tibet1987/RC_FanBoat/03_RC_setup/ailerons_as_spolier.jpg

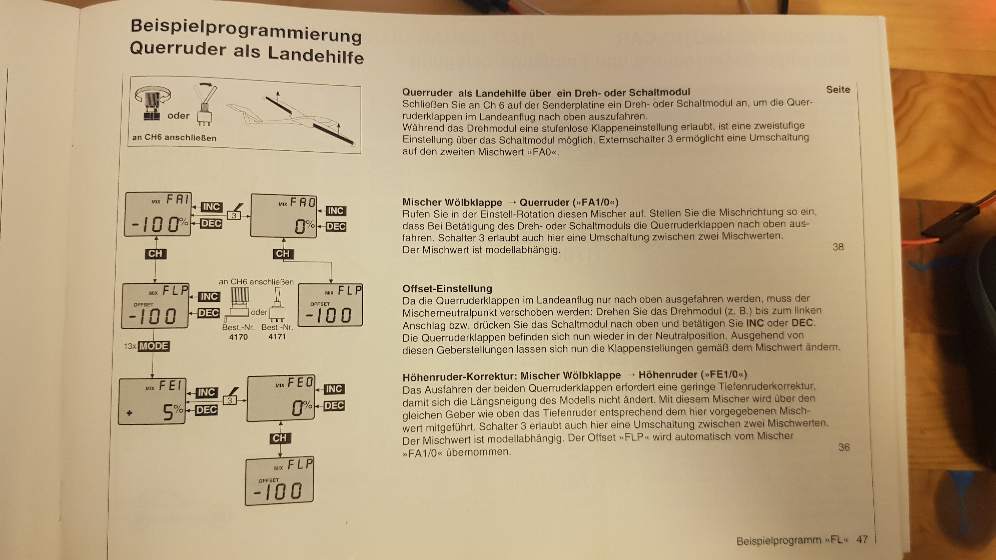
03_RC_setup/ailerons_as_spolier.jpg
