tibet1987/RC_FanBoat/04_Validation/Test_Version3/20210509_220552.jpg

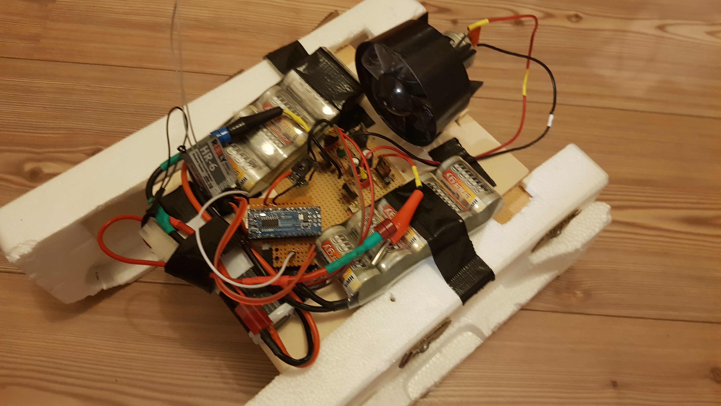
04_Validation/Test_Version3/20210509_220552.jpg
