tibet1987/RC_FanBoat/01_Hardware/Arduino-Nano-pinout.jpg

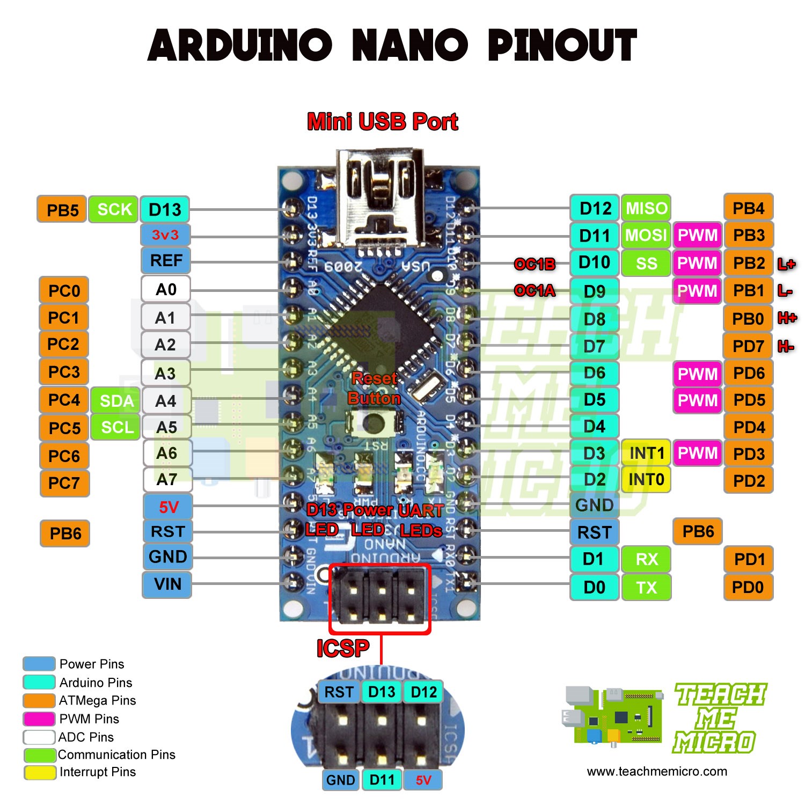
01_Hardware/Arduino-Nano-pinout.jpg
