tibet1987/RC_FanBoat/01_Hardware/Board_Layout.png

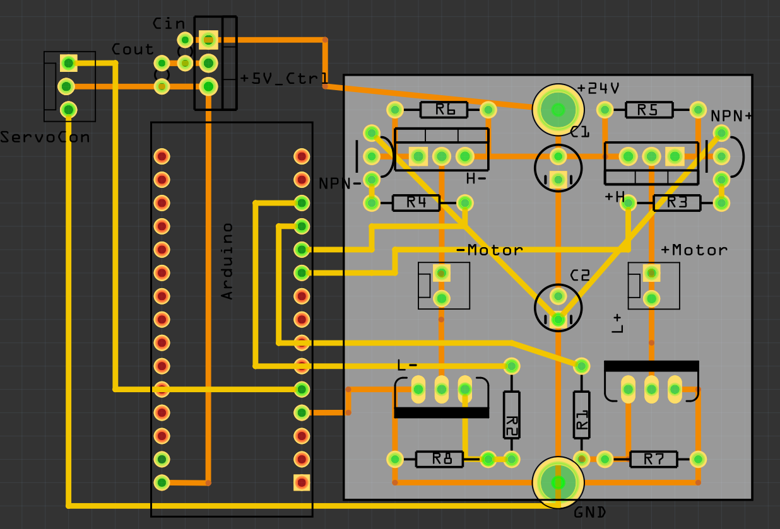
01_Hardware/Board_Layout.png
