tibet1987/RC_FanBoat/01_Hardware/FullBridge_Ports.png

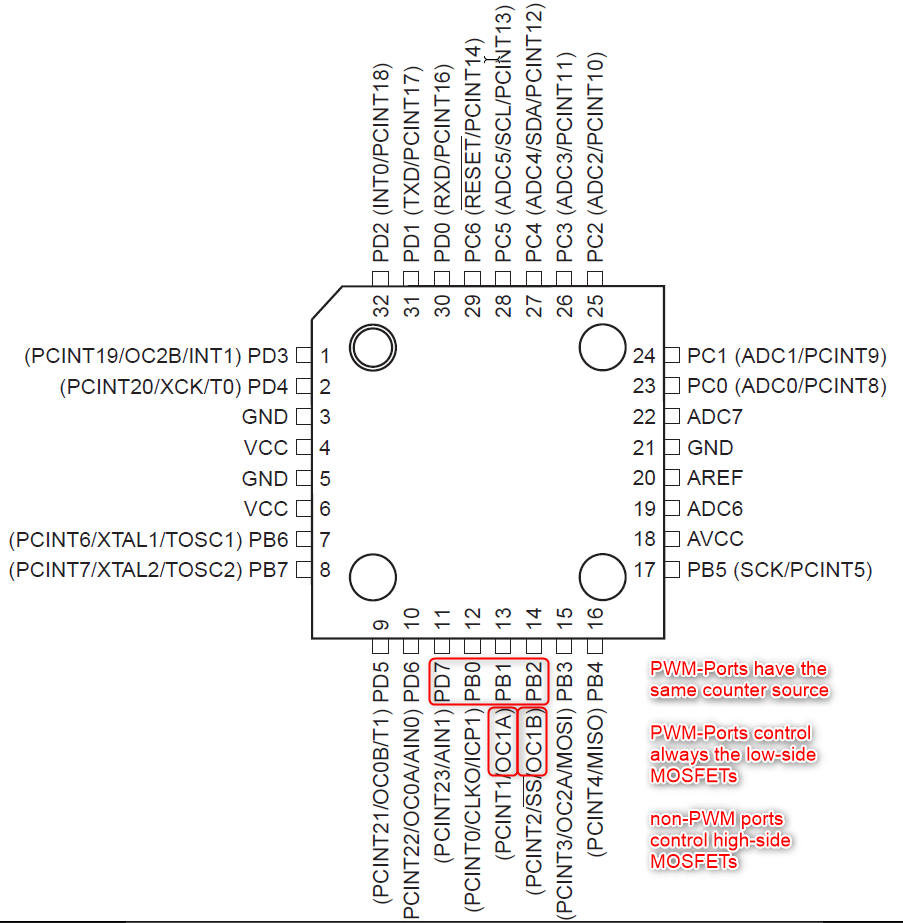
01_Hardware/FullBridge_Ports.png
