tibet1987/RC_FanBoat/01_Hardware/Schematic_VoltRegulator.png

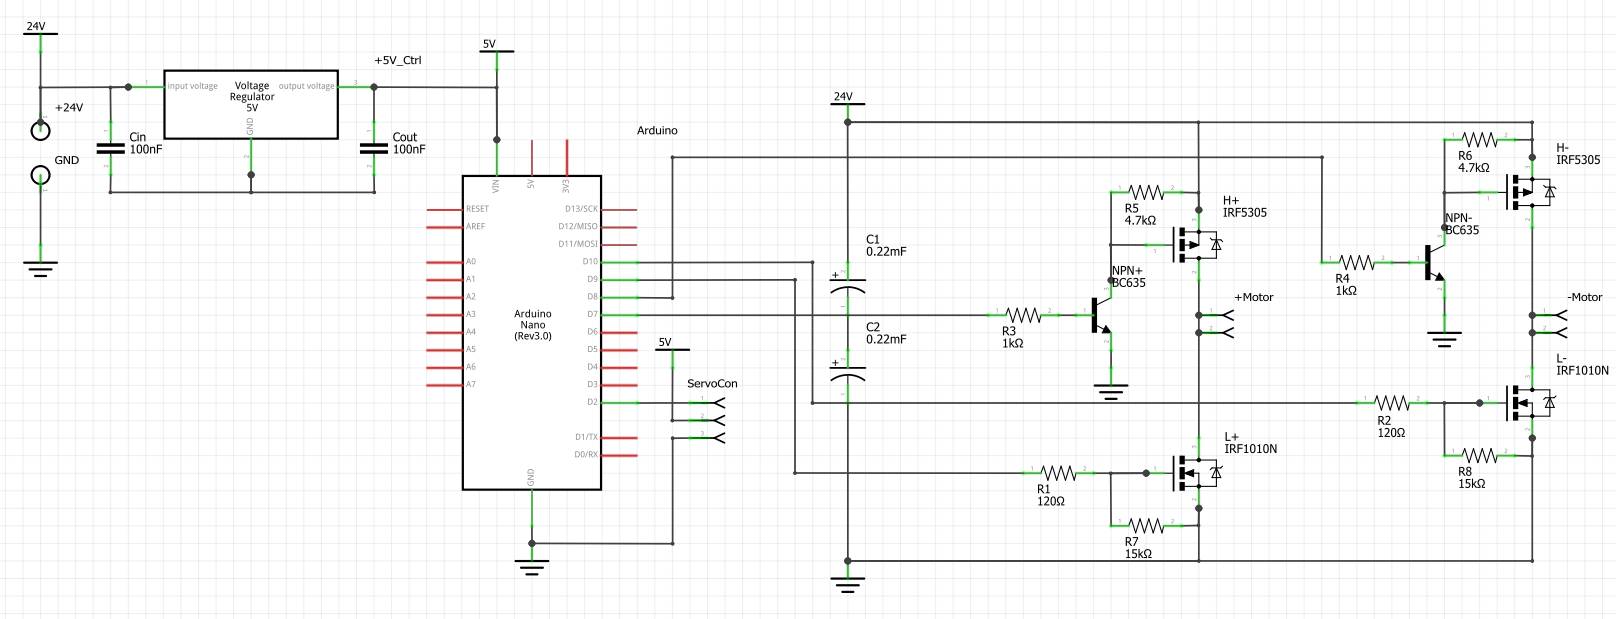
01_Hardware/Schematic_VoltRegulator.png
