tibet1987/RC_FanBoat/social_preview.png

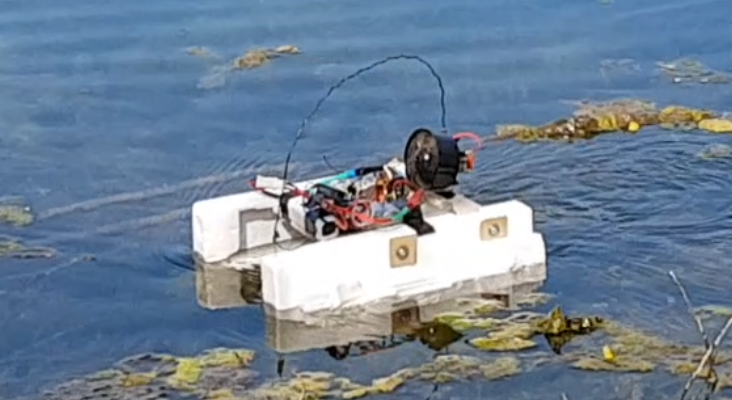
social_preview.png
