tibet1987/RC_FanBoat/01_Hardware/Schematic_StepDown.png

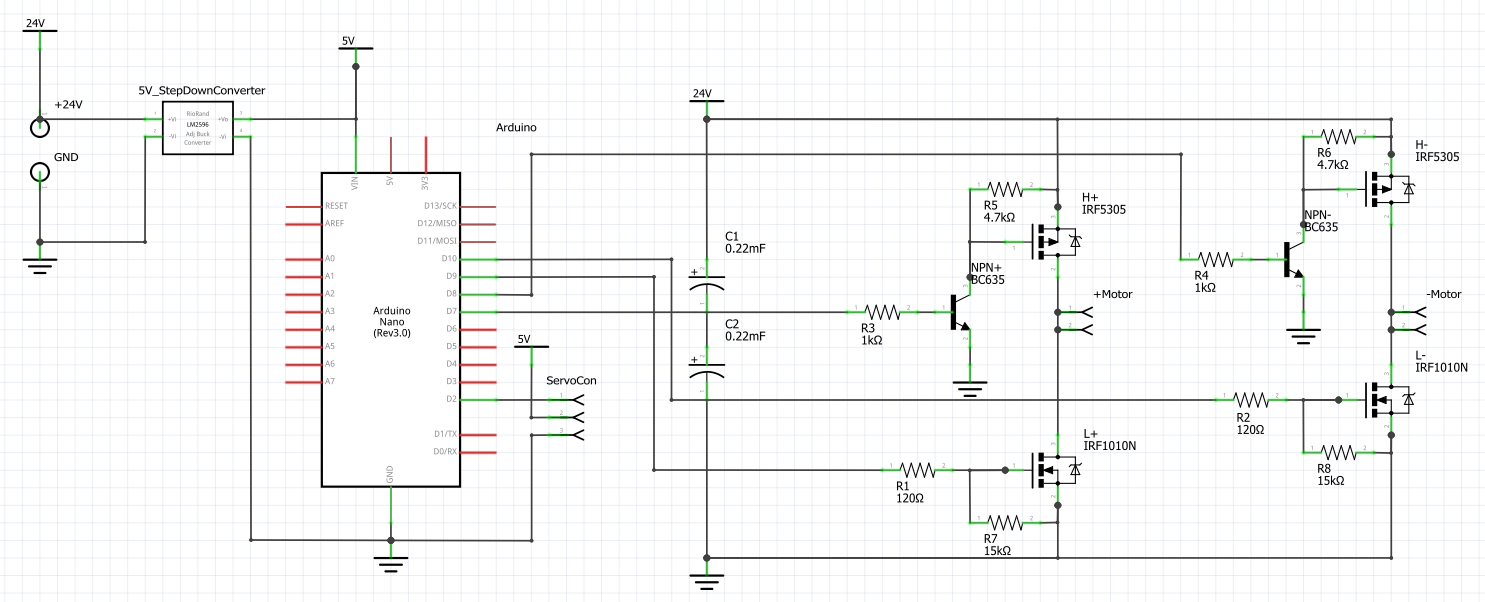
01_Hardware/Schematic_StepDown.png
