tibet1987/RC_FanBoat/01_Hardware/TotalSetup_Wiring.png

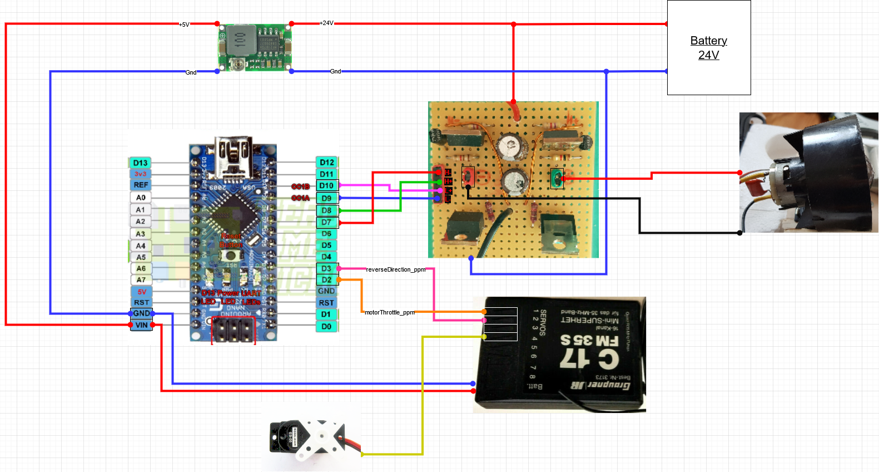
01_Hardware/TotalSetup_Wiring.png
