tibet1987/RC_FanBoat/03_RC_setup/aileron_diff_option.jpg

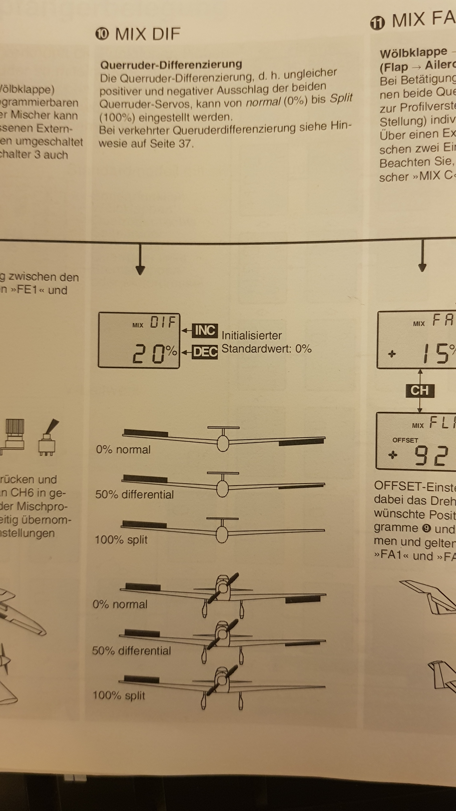
03_RC_setup/aileron_diff_option.jpg
