tibet1987/RC_FanBoat/04_Validation/Test_Version3/validation3_4800HzLowpass.jpg

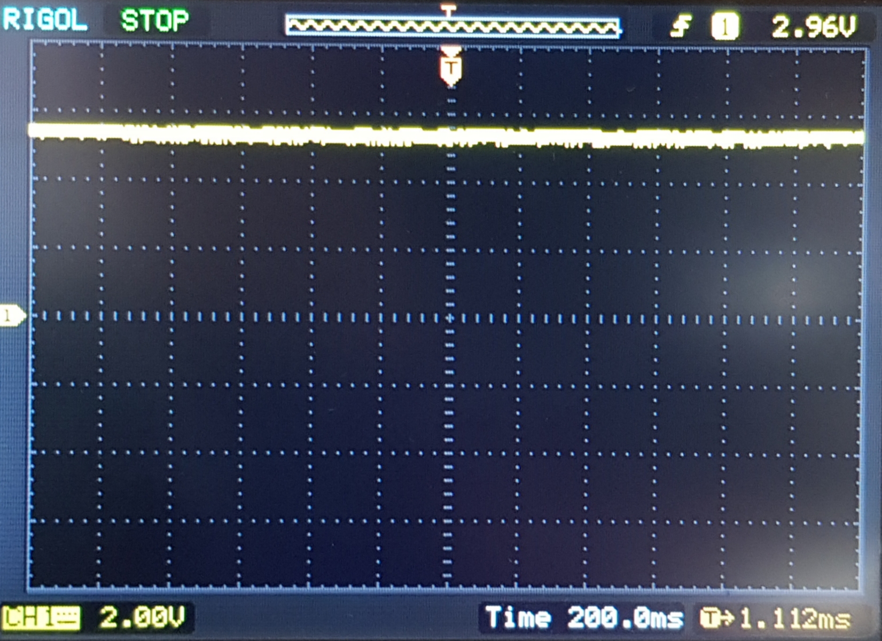
04_Validation/Test_Version3/validation3_4800HzLowpass.jpg
