tibet1987/RC_FanBoat/04_Validation/Test_Version3/validation3_with69HzLowpass_withLoad.jpg

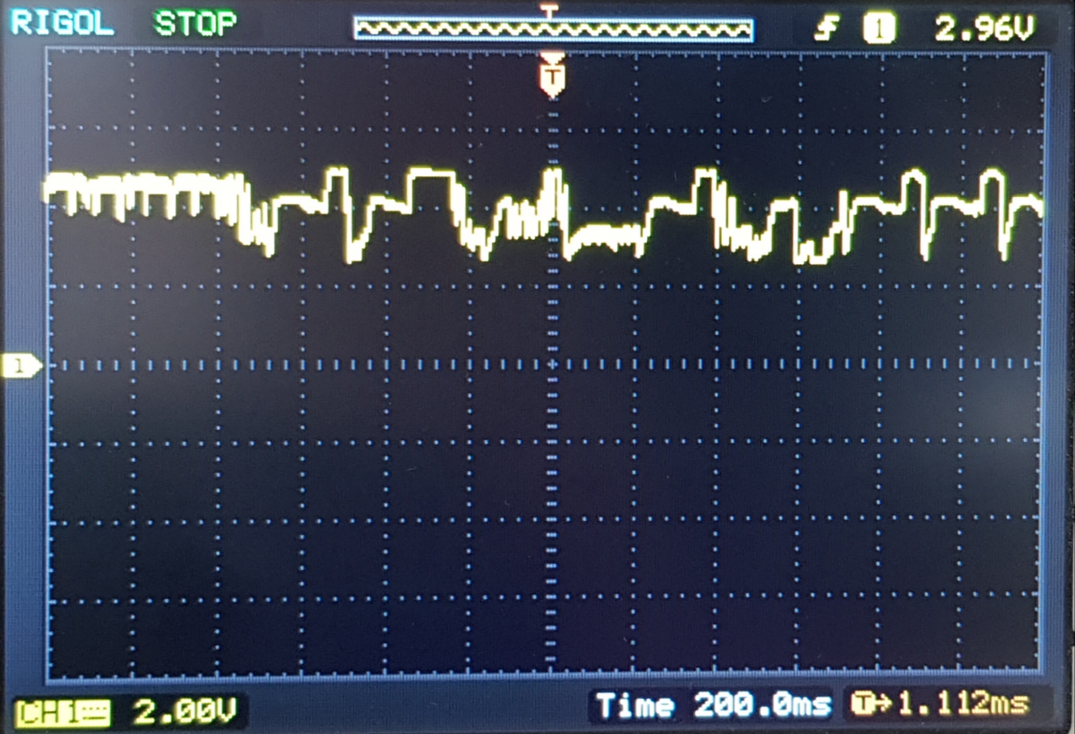
04_Validation/Test_Version3/validation3_with69HzLowpass_withLoad.jpg
