tibet1987/RC_FanBoat/(list of files, drawings)

Other design files:
01_Hardware/Hardware_v1_emitterCircuit.fzz
01_Hardware/Hardware_v2_Fullbridge.fzz
01_Hardware/Hardware_v3_Fullbridge_lowpass.fzz
