tibet1987/RC_FanBoat/(commit log)

2021-01-02 check in frist working version
    containing ino file with working working PWM for motor
    and working PPM read in
    and working PPM value to PWM value converstion
2021-01-02 Update rcFanBoat_nanoCode.ino
    optimize the interrupt function
2021-01-02 add KiCad project
    [rcFanBoat.kicad_pcb, rcFanBoat.sch]
2021-01-03 add schematic
    [rcFanBoat.sch]
2021-01-03 update schematic
    [rcFanBoat.sch]
2021-01-28 introduce hardware and software layer
    also switch from eagle hardware design to fritzing for this project
    [Hardware_v1_emitterCircuit.fzz, rcFanBoat.kicad_pcb, rcFanBoat.sch]
2021-01-28 Update Hardware_v1_emitterCircuit.fzz
    intermediate result
    [Hardware_v1_emitterCircuit.fzz]
2021-01-30 update hardware
    finish breadboard design for emmitter circuit
    start full bridge design
    [Hardware_v1_emitterCircuit.fzz, Hardware_v2_Fullbridge.fzz]
2021-01-30 Update Hardware_v1_emitterCircuit.fzz
    finalize emitter stage hardware
    [Hardware_v1_emitterCircuit.fzz]
2021-02-03 add fullbridge template and update fullbridge schematic
    [Hardware_v2_Fullbridge.fzz]
2021-02-04 finished schematic for full bridge and start layout
    [Hardware_v2_Fullbridge.fzz]
2021-02-05 Update Hardware_v2_Fullbridge.fzz
    first version of the layout fullbridge_v2 complete
    [Hardware_v2_Fullbridge.fzz]
2021-02-15 Update Hardware_v2_Fullbridge.fzz
    add part name for NPN transistor
    [Hardware_v2_Fullbridge.fzz]
2021-02-25 Update 02_rcFanBoat_arduinoNano_Hbridge.ino
    first version of testing high side switches
2021-03-07 diagram and src code update
    update pinout diagram
    add templates for switching FETs
2021-03-07 change program and add board layout
    change program to simple only forward mode (non-switchable)
    add powerstage board layout
2021-03-07 update schematic plots
    [Hardware_v2_Fullbridge.fzz]
2021-03-07 designfreeze powerstage channels
    freeze design: powerstage channels
    update pinout accordingly
    adapt SW accordingly (fix forward mode)
    [02_rcFanBoat_arduinoNano_Hbridge.ino]
2021-03-07 Update 02_rcFanBoat_arduinoNano_Hbridge.ino
    introduce second port for setting reverse direction
    [02_rcFanBoat_arduinoNano_Hbridge.ino]
2021-03-09 fix correct scaling of motor throttle signal
    [02_rcFanBoat_arduinoNano_Hbridge.ino]
2021-03-09 add schematic of whole setup
2021-03-09 bugfix on the motorThrottle signal
    [02_rcFanBoat_arduinoNano_Hbridge.ino]
